CristianDJOM/SmartTankRep/README.md

<div align="center">

# 💧 SmartTank

</div>


## 📖 Project Description

SmartTank is an Internet of Things (IoT) solution designed to monitor water tank levels in real time. The system combines an ESP32 microcontroller, ultrasonic sensing technology, and a mobile application developed with React Native to provide remote access to water level information.

The ultrasonic sensor continuously measures the distance between the sensor and the water surface, allowing the system to calculate the tank filling percentage. The collected data is transmitted through the ESP32 and displayed in a user-friendly mobile application, enabling users to monitor tank status from anywhere.

SmartTank helps prevent water shortages, improves resource management, and provides a practical example of IoT integration between hardware and software systems.

---

## 🎯 Objectives

* Monitor water tank levels in real time.
* Provide remote access through a mobile application.
* Improve water resource management.
* Demonstrate IoT integration using ESP32 and sensors.

---

## ✨ Features

* Real-time water level monitoring.
* Tank filling percentage calculation.
* Mobile application visualization.
* Wireless communication.
* User-friendly interface.
* IoT-based architecture.

---

## 🛠️ Technologies Used

### Mobile Application

* React Native
* Expo Go

### Embedded Systems

* ESP32
* Ultrasonic Sensor

### Programming Languages

* JavaScript
* C++

### Concepts

* Internet of Things (IoT)
* Sensor Integration
* Wireless Monitoring

---

## 🔌 Hardware Components

* ESP32
* Ultrasonic Sensor
* Water Tank Prototype
* Power Supply
